maxlab-io/esp32-prog/esp32-prog.kicad_pcb

## KiCad design esp32-prog.kicad_pcb (2024-07-16)

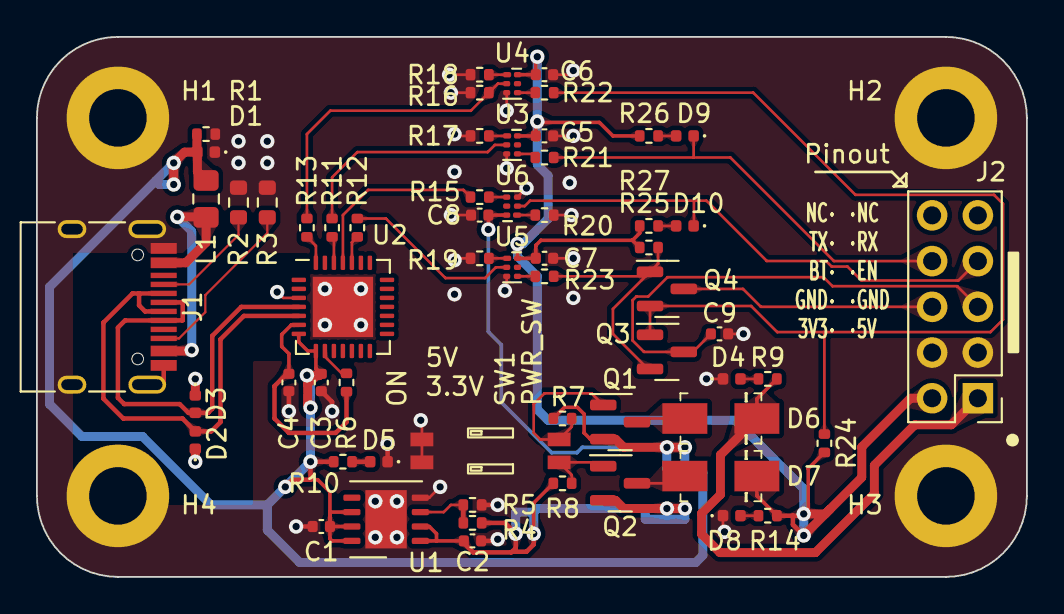
[picture p1: board esp32-prog.kicad_pcb from above]

Board: 2 copper layers, 55.0 x 30.0 mm, 64 parts (0 on the bottom side), 43 nets.

Parts:
C1, C2, C3, C4, C5, C6, C7, C8, C9: 10u_0402_LDK105CBJ106MVLF; C_0402_1005Metric
D1, D2, D3: SOD-882_0402_RCLAMP0521P-N; D_0402_1005Metric
D4, D5, D8: 0402_RED_16-213SDRC/S530-A3/TR8; LED_0402_1005Metric
D6, D7: SS34; DO-214AC
D9, D10: 0402_BLUE_NCD0402B1; LED_0402_1005Metric
H1, H2, H3, H4: MH; MountingHole_3.2mm_M3_ISO7380_Pad
J1: TYPE-C-31-M-12; USB_C_Receptacle_HRO_TYPE-C-31-M-12
J2: Conn-02x05_PZ254-2-05-Z-8.5; PinHeader_2x05_P2.54mm_Vertical
L1: FB_2A_0805_220R@100MHz_BLM21PG221SN1D; L_0805_2012Metric_Pad1.15x1.40mm_HandSolder
Q1, Q2: AO3401A; SOT-23
Q3, Q4: AO3400A; SOT-23
R1, R5, R6, R7, R8, R16, R17, R18, R19, R20, R24, R25: 10k_0402_0402WGF1002TCE; R_0402_1005Metric
R2, R3: 5.1k_0603_0603WAF5101T5E; R_0603_1608Metric
R4: 56k_0402_ERJ2RKF5602X; R_0402_1005Metric
R9, R10, R14, R26, R27: 1k_0402_0402WGF1001TCE; R_0402_1005Metric
R11, R12, R13, R15, R21, R22, R23: 32.4R_0402_AC0402FR-0732R4L; R_0402_1005Metric
SW1: SW_DIP_x02_50mil_1.27mm_TP-02; SW_DIP_1.27mm_0.50mil_TP-02
U1: LD39200DPUR; DFN-8-1EP_4x4mm_P0.8mm_EP2.3x3.24mm
U2: CP2102-GMR; QFN-28-1EP_5x5mm_P0.5mm_EP3.35x3.35mm
U3, U4, U5, U6: TI_SN74LVC1G125DRYR; Texas_USON-6_1x1.45mm_P0.5mm_SMD

Connections:
+3.3V: C5.1, C6.1, C7.1, D7.K, J2.2, R14.1, R24.1, R25.1, R26.1, R27.1, U3.6 (V), U4.6 (V), U5.6 (V)
+3.3VA: C2.2, Q2.2 (S), R4.1, R8.1, U1.1 (OUT), U1.2 (OUT)
+5V: D6.K, J2.1, R9.1
/ESP_BOOT: J2.6, Q4.3 (D)
/ESP_EN: C9.1, J2.5, Q3.3 (D)
/RXD: D10.1 (K), J2.7, U6.2
/TXD: D9.1 (K), J2.8, R21.2
/UD+: D3.2 (A2), J1.A6 (D+), J1.B6 (D+), U2.4 (D+)
/UD-: D2.2 (A2), J1.A7 (D-), J1.B7 (D-), U2.5 (D-)
GND: C1.1, C2.1, C3.2, C4.2, C5.2, C6.2, C7.2, C8.2, C9.2, D1.1 (A1), D2.1 (A1), D3.1 (A1), D4.1 (K), D5.1 (K), D8.1 (K), H1.1, H2.1, H3.1, H4.1, J1.A1 (GND), J1.A12 (GND), J1.B1 (GND), J1.B12 (GND), J1.S1 (SHIELD), J2.3, J2.4, R1.2, R2.2, R3.2, R5.2, R16.1, R17.2, R18.2, R19.2, R20.2, SW1.1, SW1.2, U1.4 (GND), U1.9 (PAD), U2.3 (GND), U2.29 (GND), U3.3 (G), U4.3 (G), U5.3 (G), U6.3 (G)
unnamed: D4.2 (A), R9.2
unnamed: D5.2 (A), R10.2
unnamed: D8.2 (A), R14.2
unnamed: D9.2 (A), R26.2
unnamed: D10.2 (A), R27.2
unnamed: J1.A5 (CC1), R2.1
unnamed: J1.B5 (CC2), R3.1
unnamed: J1.A4 (VBUS), J1.A9 (VBUS), J1.B4 (VBUS), J1.B9 (VBUS), L1.1
unnamed: D6.A, Q1.3 (D)
unnamed: Q1.1 (G), R7.2, SW1.4
unnamed: D7.A, Q2.3 (D)
unnamed: Q2.1 (G), R8.2, SW1.3
unnamed: Q3.1 (G), Q4.2 (S), R22.2, R24.2
unnamed: Q3.2 (S), Q4.1 (G), R23.2, R25.2
unnamed: R11.2, U3.2
unnamed: R12.2, U5.2
unnamed: R13.2, R16.2, U4.2
unnamed: R15.2, U6.4
unnamed: R17.1, U3.1
unnamed: R18.1, U4.1
unnamed: R19.1, U5.1
unnamed: R20.1, U6.1
unnamed: R21.1, U3.4
unnamed: R22.1, U4.4
unnamed: R23.1, U5.4
unnamed: R4.2, R5.1, U1.3 (ADJ)
unnamed: R15.1, U2.25 (RXD)
unnamed: R11.1, U2.26 (TXD)
unnamed: C4.1, R6.2, U2.6 (VDD)
unnamed: R13.1, U2.28 (~DTR)
unnamed: R6.1, U2.9 (~RST)
unnamed: R12.1, U2.24 (~RTS)
VBUS: C1.2, C3.1, C8.1, D1.2 (A2), L1.2, Q1.2 (S), R1.1, R7.1, R10.1, U1.6 (EN), U1.7 (IN), U1.8 (IN), U2.7 (VREGIN), U2.8 (VBUS), U6.6 (V)
