maxlab-io/esp32-prog/(commit log)

2022-11-04 draft schematics
    [esp32-prog.kicad_pcb, esp32-prog.kicad_sch]
2022-11-07 draft schematics complete
    [esp32-prog.kicad_pcb, esp32-prog.kicad_sch]
2022-11-07 fix DRC in schematics
    [esp32-prog.kicad_sch]
2022-11-07 begin routing: place all basic blocks
    [esp32-prog.kicad_pcb, esp32-prog.kicad_sch]
2022-11-08 draft route complete
    [esp32-prog.kicad_pcb, esp32-prog.kicad_sch]
2022-11-08 draft route: add more gnd guard traces
    [esp32-prog.kicad_pcb]
2022-11-08 draft route: complete, ready for review
    [esp32-prog.kicad_pcb, esp32-prog.kicad_sch]
2022-11-09 route: addressed R. comments w.r.t. power assign
    [esp32-prog.kicad_pcb, esp32-prog.kicad_sch]
2022-11-09 route: add fancy silk
    [esp32-prog.kicad_pcb]
2022-11-09 fab: add jlcpcb export
    [esp32-prog-B_Cu.gbr, esp32-prog-B_Fab.gbr, esp32-prog-B_Mask.gbr, esp32-prog-B_Paste.gbr, esp32-prog-B_Silkscreen.gbr, esp32-prog-Edge_Cuts.gbr, esp32-prog-F_Cu.gbr, esp32-prog-F_Fab.gbr]
2022-11-09 fab: fix jlcpcb export - cpl file and such
    [esp32-prog.kicad_sch]
2022-11-09 fab: fix 4.7u cap and buffer FP
    [esp32-prog-B_Cu.gbr, esp32-prog-B_Fab.gbr, esp32-prog-B_Mask.gbr, esp32-prog-B_Paste.gbr, esp32-prog-B_Silkscreen.gbr, esp32-prog-Edge_Cuts.gbr, esp32-prog-F_Cu.gbr, esp32-prog-F_Fab.gbr]
2023-07-25 pcb: next revision schematics and prelim routing
    [esp32-prog.kicad_pcb, esp32-prog.kicad_sch]
2023-08-09 pcb: add markings for the tag connector and pwr switch
    [esp32-prog.kicad_pcb, esp32-prog.kicad_sch]
2023-08-09 fab: preparing rev2 files
    [esp32-prog-B_Cu.gbr, esp32-prog-B_Fab.gbr, esp32-prog-B_Mask.gbr, esp32-prog-B_Paste.gbr, esp32-prog-B_Silkscreen.gbr, esp32-prog-Edge_Cuts.gbr, esp32-prog-F_Cu.gbr, esp32-prog-F_Fab.gbr]
2024-07-16 address the incorect pinout of the LD39200DPUR
    [esp32-prog-B_Cu.gbr, esp32-prog-B_Fab.gbr, esp32-prog-B_Mask.gbr, esp32-prog-B_Paste.gbr, esp32-prog-B_Silkscreen.gbr, esp32-prog-Edge_Cuts.gbr, esp32-prog-F_Cu.gbr, esp32-prog-F_Fab.gbr]
